szakmariadam/breathalyzer-project/pcb/breathalyzer/models/25SH-B-04-TS.stp

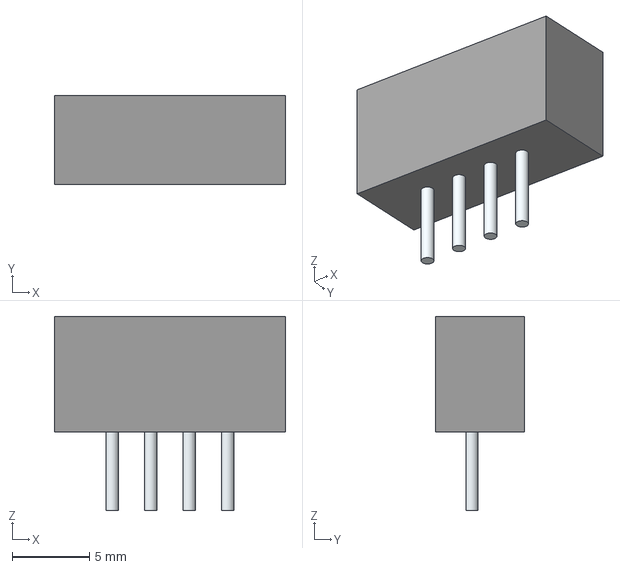
[picture p11: CAD file, 2025-05-30]
pcb/breathalyzer/models/25SH-B-04-TS.stp
15.0 x 5.75 x 12.6 mm
Leads
