szakmariadam/breathalyzer-project/pcb/breathalyzer/models/LCD-S301C31TR.stp

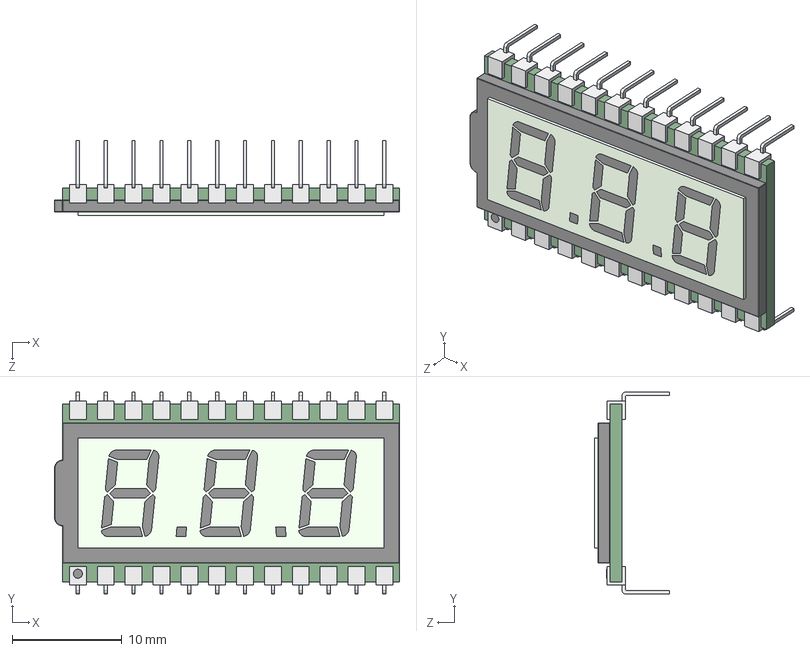
[picture p12: CAD file, 2025-05-30]
pcb/breathalyzer/models/LCD-S301C31TR.stp
31.5 x 18.4 x 6.80 mm
pcb
terminal_13
terminal_14
terminal_11
terminal_22
terminal_4
terminal_12
terminal_20
terminal_5
terminal_15
terminal_10
terminal_24
terminal_23
terminal_3
terminal_21
terminal_7
terminal_6
terminal
terminal_17
terminal_8
terminal_19
terminal_9
terminal_16
terminal_18
terminal_2
lcd base
glass
digits
digits_10
digits_16
digits_17
digits_2
digits_18
digits_9
digits_20
digits_5
digits_7
digits_21
digits_19
digits_15
digits_23
digits_12
digits_11
digits_4
digits_3
digits_22
digits_13
digits_6
digits_8
digits_14
logo_2
