szakmariadam/breathalyzer-project/pcb/breathalyzer/models/CPT-14146-80T.stp

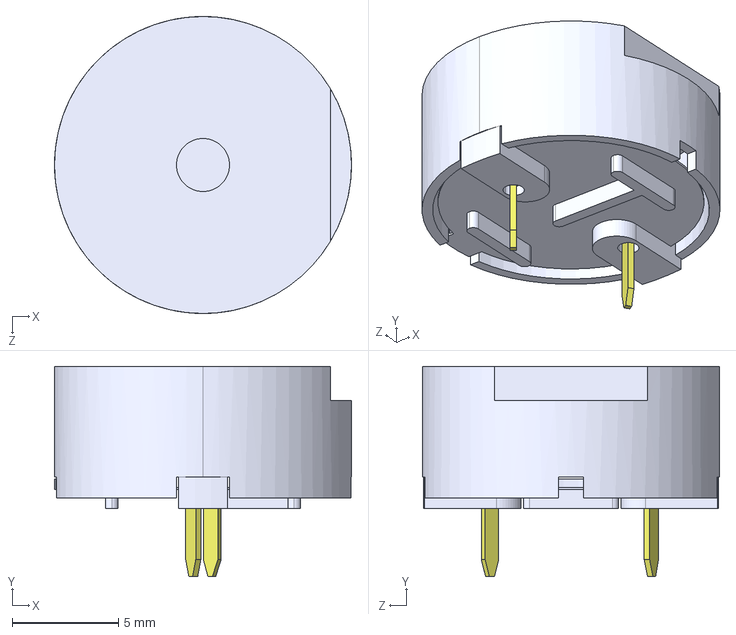
[picture p13: CAD file, 2025-05-30]
pcb/breathalyzer/models/CPT-14146-80T.stp
14.0 x 9.90 x 14.0 mm
