szakmariadam/breathalyzer-project/pcb/breathalyzer/models/22-28-8073.stp

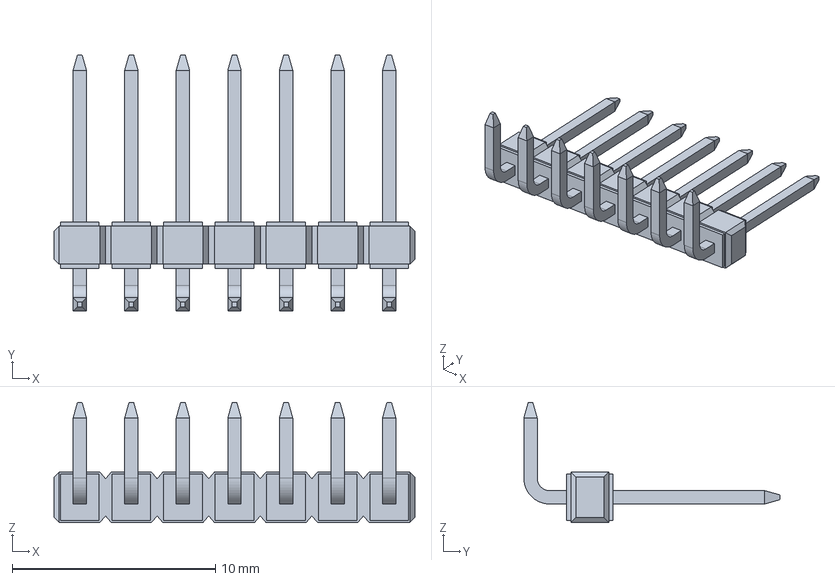
[picture p14: CAD file, 2025-05-30]
pcb/breathalyzer/models/22-28-8073.stp
17.8 x 12.6 x 5.92 mm
