szakmariadam/breathalyzer-project/pcb/breathalyzer/models/44J_ATM.step

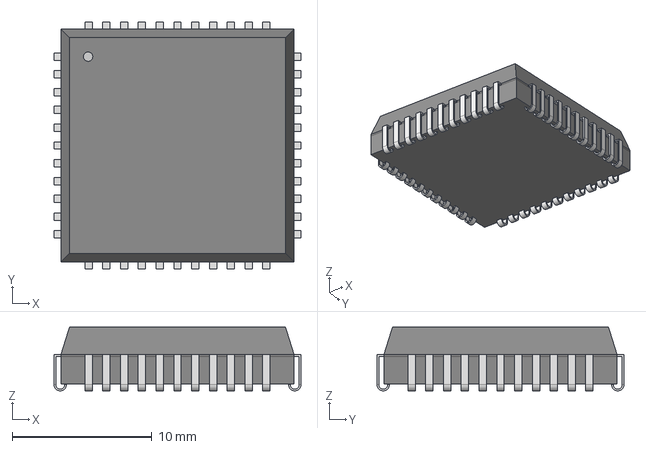
[picture p15: CAD file, 2025-05-30]
pcb/breathalyzer/models/44J_ATM.step
17.7 x 17.7 x 4.56 mm
