szakmariadam/breathalyzer-project/pcb/breathalyzer/models/Download_STP_430162085826_rev1.stp

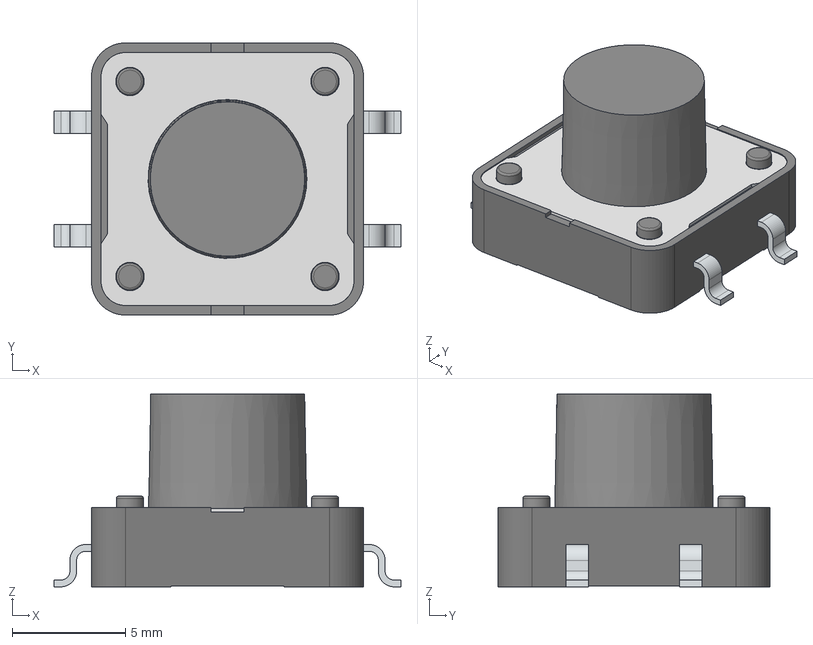
[picture p16: CAD file, 2025-05-30]
pcb/breathalyzer/models/Download_STP_430162085826_rev1.stp
15.3 x 12.0 x 8.50 mm
Contactplates x 5
Frame x 5
Contact Plate
Cover
Stem
Terminal x 4
