szakmariadam/breathalyzer-project/pcb/breathalyzer/models/PTS636SM43JSMTR_LFS.stp

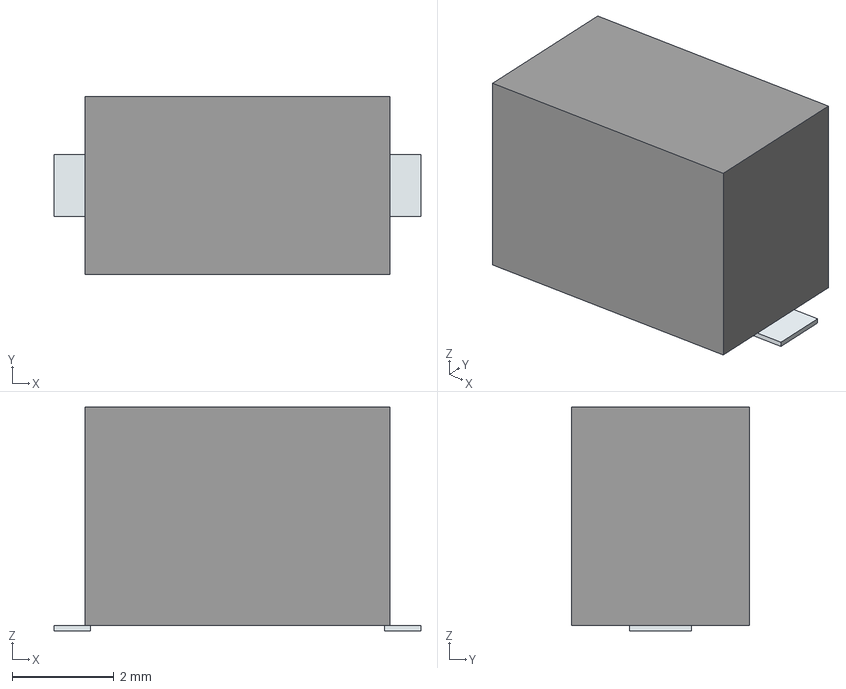
[picture p17: CAD file, 2025-05-30]
pcb/breathalyzer/models/PTS636SM43JSMTR_LFS.stp
7.22 x 3.50 x 4.40 mm
Pins
