szakmariadam/breathalyzer-project/pcb/breathalyzer/models/140-504-415-001.stp

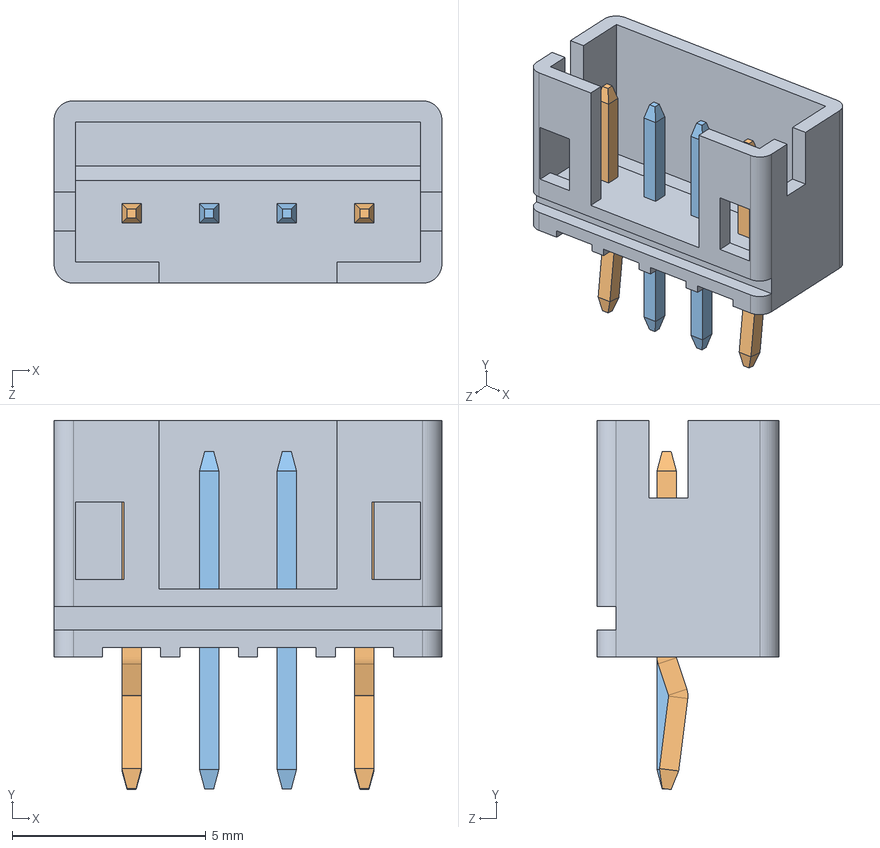
[picture p18: CAD file, 2025-05-30]
pcb/breathalyzer/models/140-504-415-001.stp
10.0 x 9.51 x 4.70 mm
V Housing_504
V Contact_Kink x 2
V Contact_Str x 2
