szakmariadam/breathalyzer-project/pcb/breathalyzer/models/PTS636_SK25F_SMTR_LFS.stp

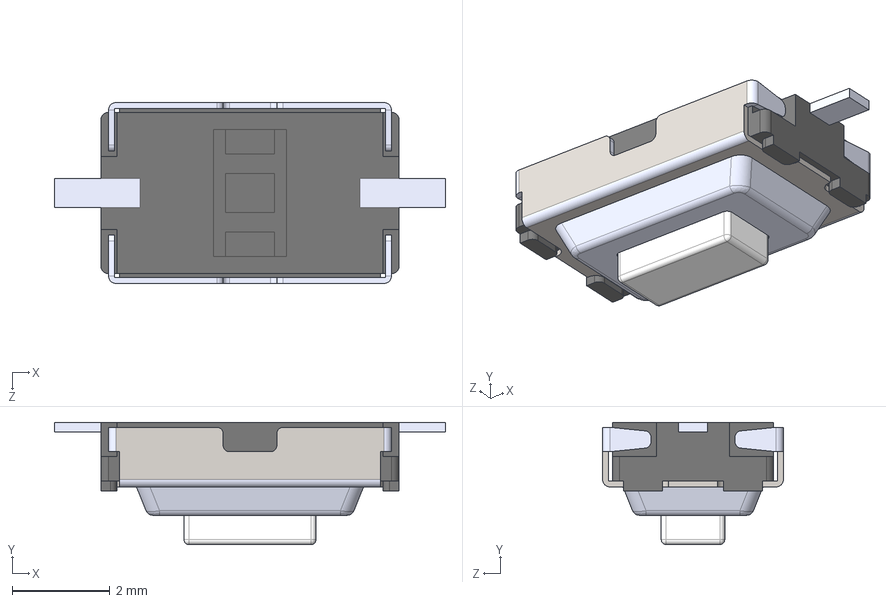
[picture p19: CAD file, 2025-05-30]
pcb/breathalyzer/models/PTS636_SK25F_SMTR_LFS.stp
8.00 x 2.50 x 3.70 mm
