szakmariadam/breathalyzer-project/pcb/breathalyzer/models/430162085826.stp

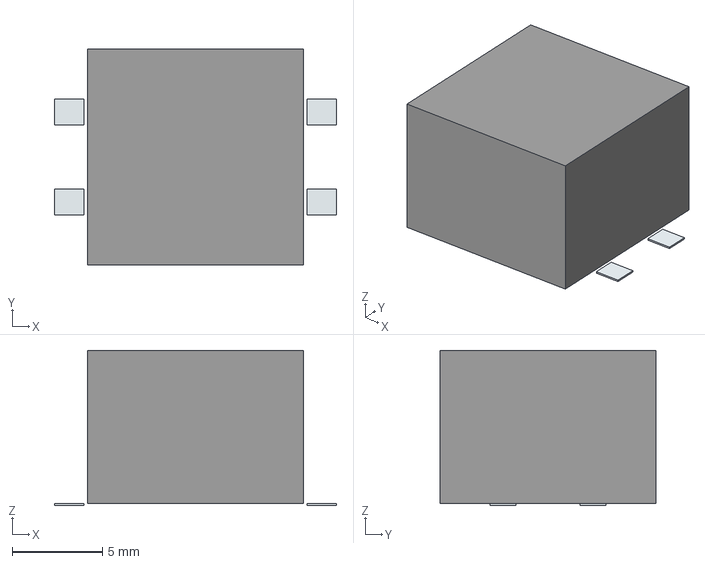
[picture p20: CAD file, 2025-05-30]
pcb/breathalyzer/models/430162085826.stp
15.6 x 12.0 x 8.60 mm
Pins
