szakmariadam/breathalyzer-project/pcb/breathalyzer/models/440055-2.stp

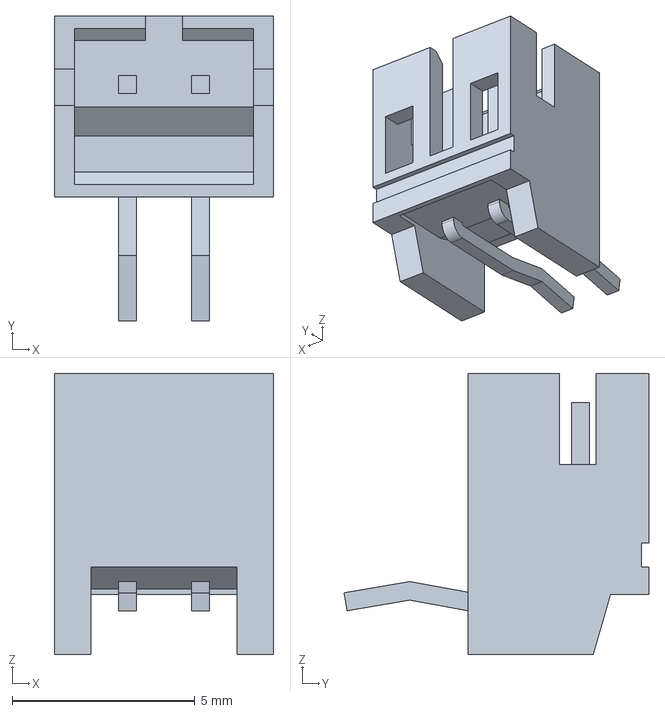
[picture p21: CAD file, 2025-05-30]
pcb/breathalyzer/models/440055-2.stp
6.00 x 8.35 x 7.70 mm
