szakmariadam/breathalyzer-project/pcb/breathalyzer/models/601030.stp

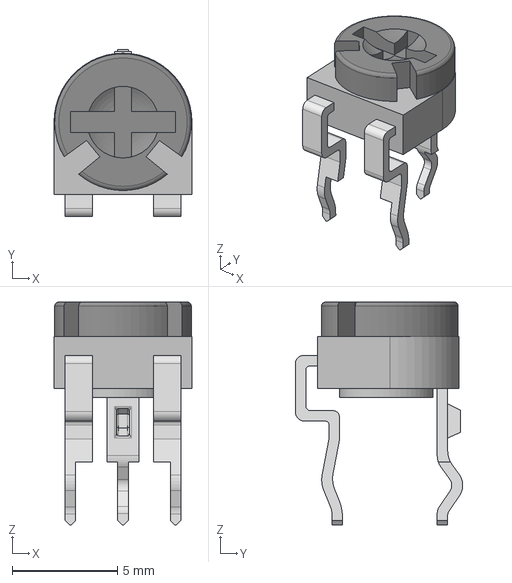
[picture p22: CAD file, 2025-05-30]
pcb/breathalyzer/models/601030.stp
6.56 x 7.96 x 10.6 mm
