szakmariadam/breathalyzer-project/pcb/breathalyzer/breathalyzer.kicad_pcb

## KiCad design pcb/breathalyzer/breathalyzer.kicad_pcb (2025-05-30)

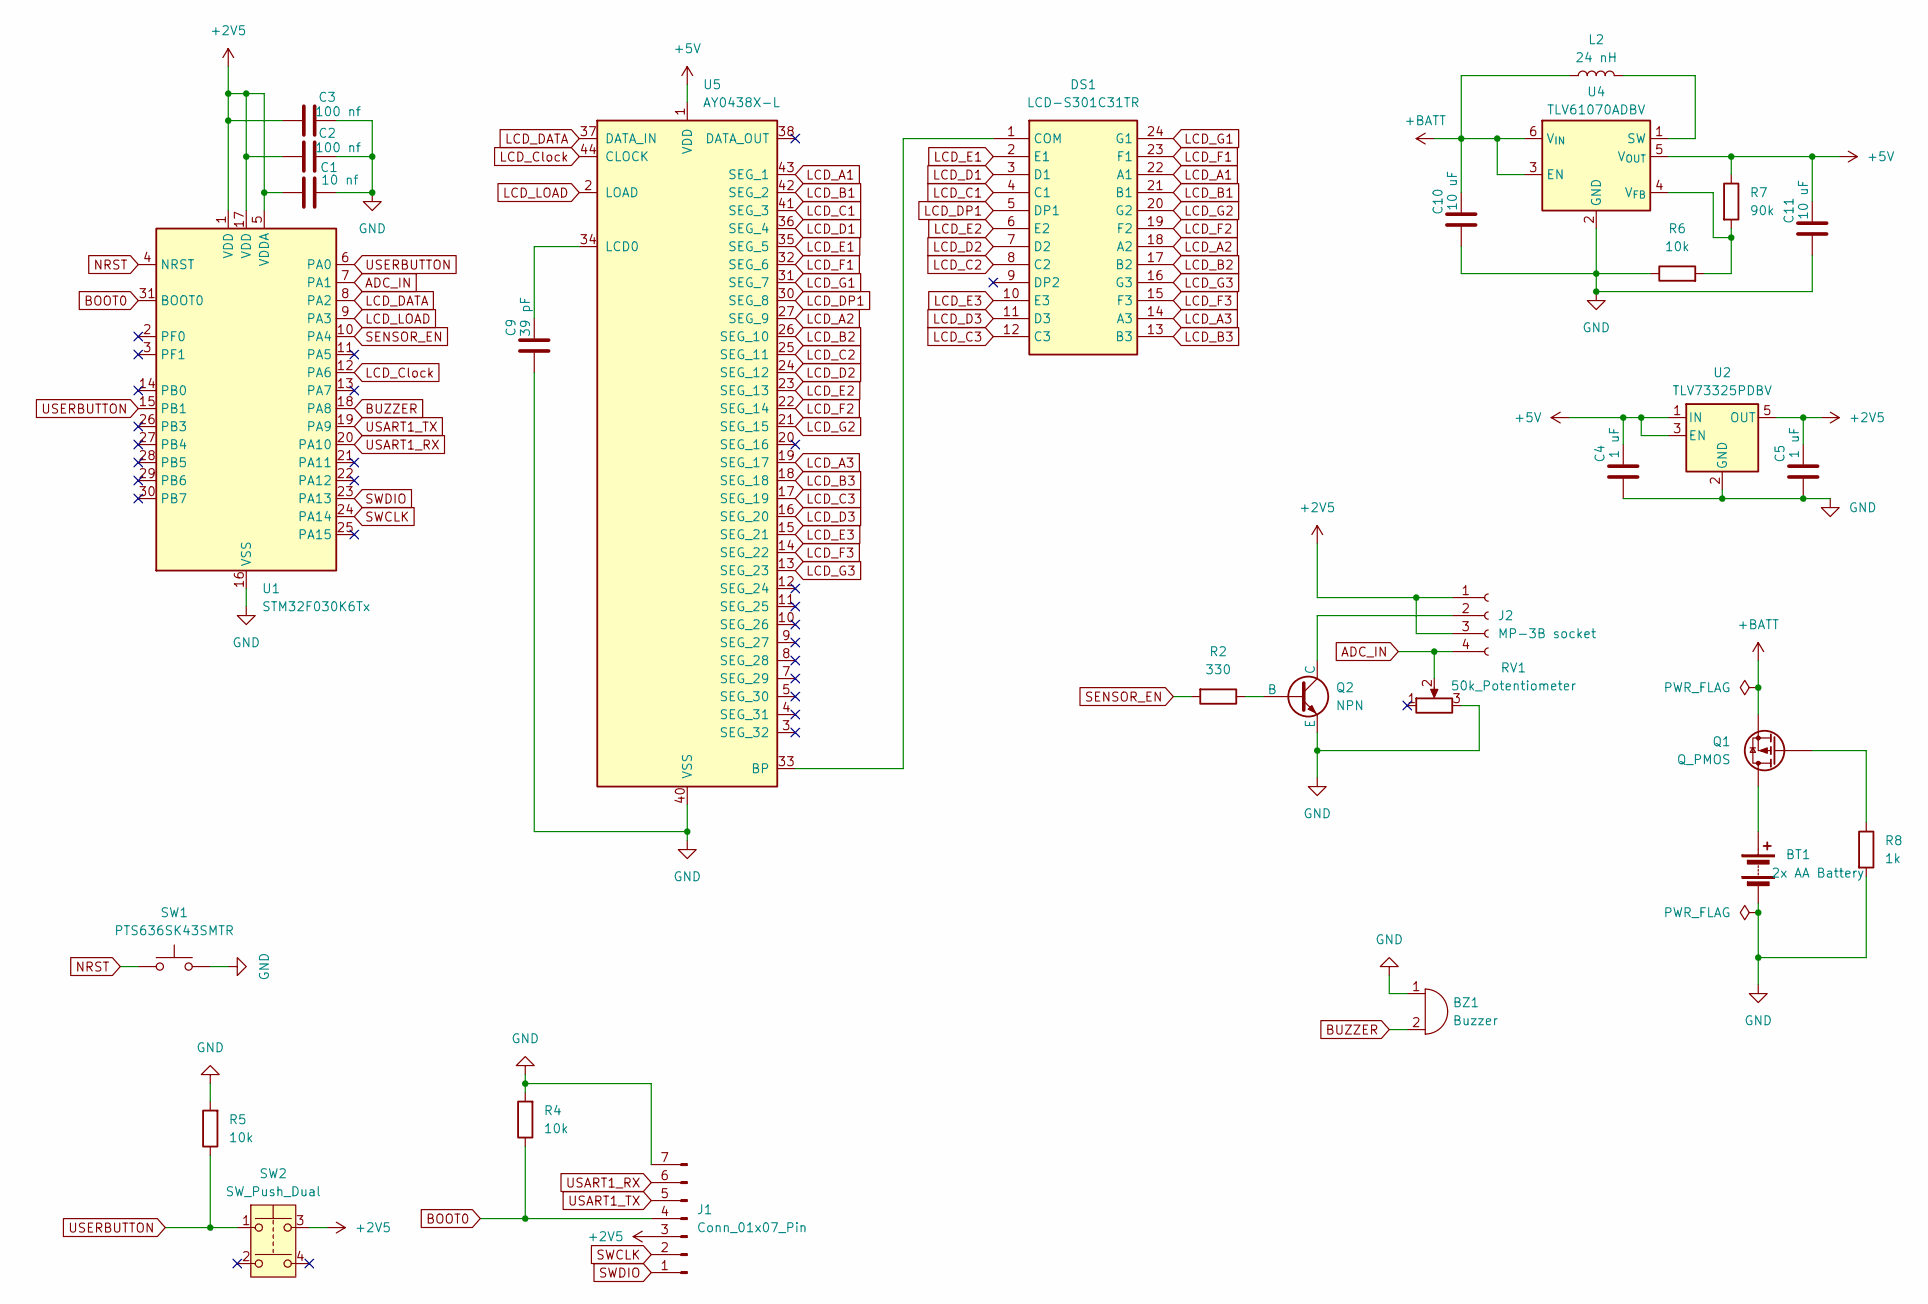
[picture p23: schematic breathalyzer.kicad_sch]

Parts:
BT1: 2x AA Battery; SHDRRA2W50P0X200_1X2_600X770X525P
BZ1: Buzzer; CPT1414680T
C1: 10 nf; C_01005_0402Metric
C2, C3: 100 nf; C_0402_1005Metric
C4, C5: 1 uF; C_0603_1608Metric
C9: 39 pF; C_0603_1608Metric
C10, C11: 10 uF; C_0805_2012Metric
DS1: LCD-S301C31TR; Mouser Part Number 696-LCD-S301C31TR
J1: Conn_01x07_Pin; HDRRA7W66P0X254_1X7_1778X229X274P
J2: MP-3B socket; 25SHB04TS
L2: 24 nH; L_1008_2520Metric
Q1: Q_PMOS; SOT-23-3
Q2: NPN; SOT-23-3
R2: 330; R_0805_2012Metric
R4, R5, R6: 10k; R_0603_1608Metric
R7: 90k; R_1206_3216Metric
R8: 1k; R_0603_1608Metric
RV1: 50k_Potentiometer; Potentiometer_ACP_CA9-H5_Horizontal
SW1: PTS636SK43SMTR; PTS636SM43JSMTRLFS
SW2: SW_Push_Dual; 430162085826
U1: STM32F030K6Tx; LQFP-32_7x7mm_P0.8mm
U2: TLV73325PDBV; SOT-23-5
U4: TLV61070ADBV; SOT-23-6
U5: AY0438X-L; PLCC-44

Connections:
+2V5: C1.1, C2.1, C3.1, C5.2, J1.3, J2.1, J2.3, SW2.3, U1.1 (VDD), U1.5 (VDDA), U1.17 (VDD), U2.5 (OUT)
+5V: C4.2, C11.2, R7.1, U2.1 (IN), U2.3 (EN), U4.5 (V_{OUT}), U5.1 (VDD)
+BATT: C10.2, L2.1, Q1.2 (S), U4.3 (EN), U4.6 (V_{IN})
ADC_IN: J2.4, RV1.2, U1.7 (PA1)
BOOT0: J1.4, R4.1, U1.31 (BOOT0)
BUZZER: BZ1.2 (-), U1.18 (PA8)
GND: BT1.2 (-), BZ1.1 (+), C1.2, C2.2, C3.2, C4.1, C5.1, C9.1, C10.1, C11.1, J1.7, Q2.3 (E), R4.2, R5.2, R6.1, R8.2, RV1.3, SW1.2, U1.16 (VSS), U1.32 (VSS), U2.2 (GND), U4.2 (GND), U5.40 (VSS)
LCD_A1: DS1.22 (A1), U5.43 (SEG_1)
LCD_A2: DS1.18 (A2), U5.27 (SEG_9)
LCD_A3: DS1.14 (A3), U5.19 (SEG_17)
LCD_B1: DS1.21 (B1), U5.42 (SEG_2)
LCD_B2: DS1.17 (B2), U5.26 (SEG_10)
LCD_B3: DS1.13 (B3), U5.18 (SEG_18)
LCD_C1: DS1.4 (C1), U5.41 (SEG_3)
LCD_C2: DS1.8 (C2), U5.25 (SEG_11)
LCD_C3: DS1.12 (C3), U5.17 (SEG_19)
LCD_Clock: U1.12 (PA6), U5.44 (CLOCK)
LCD_D1: DS1.3 (D1), U5.36 (SEG_4)
LCD_D2: DS1.7 (D2), U5.24 (SEG_12)
LCD_D3: DS1.11 (D3), U5.16 (SEG_20)
LCD_DATA: U1.8 (PA2), U5.37 (DATA_IN)
LCD_DP1: DS1.5 (DP1), U5.30 (SEG_8)
LCD_E1: DS1.2 (E1), U5.35 (SEG_5)
LCD_E2: DS1.6 (E2), U5.23 (SEG_13)
LCD_E3: DS1.10 (E3), U5.15 (SEG_21)
LCD_F1: DS1.23 (F1), U5.32 (SEG_6)
LCD_F2: DS1.19 (F2), U5.22 (SEG_14)
LCD_F3: DS1.15 (F3), U5.14 (SEG_22)
LCD_G1: DS1.24 (G1), U5.31 (SEG_7)
LCD_G2: DS1.20 (G2), U5.21 (SEG_15)
LCD_G3: DS1.16 (G3), U5.13 (SEG_23)
LCD_LOAD: U1.9 (PA3), U5.2 (LOAD)
NRST: SW1.1, U1.4 (NRST)
unnamed: BT1.1 (+), Q1.3 (D)
unnamed: DS1.1 (COM), U5.33 (BP)
unnamed: J2.2, Q2.1 (C)
unnamed: Q1.1 (G), R8.1
unnamed: Q2.2 (B), R2.1
unnamed: L2.2, U4.1 (SW)
unnamed: R6.2, R7.2, U4.4 (V_{FB})
unnamed: C9.2, U5.34 (LCD0)
SENSOR_EN: R2.2, U1.10 (PA4)
SWCLK: J1.2, U1.24 (PA14)
SWDIO: J1.1, U1.23 (PA13)
USART1_RX: J1.6, U1.20 (PA10)
USART1_TX: J1.5, U1.19 (PA9)
USERBUTTON: R5.1, SW2.1, U1.6 (PA0), U1.15 (PB1)

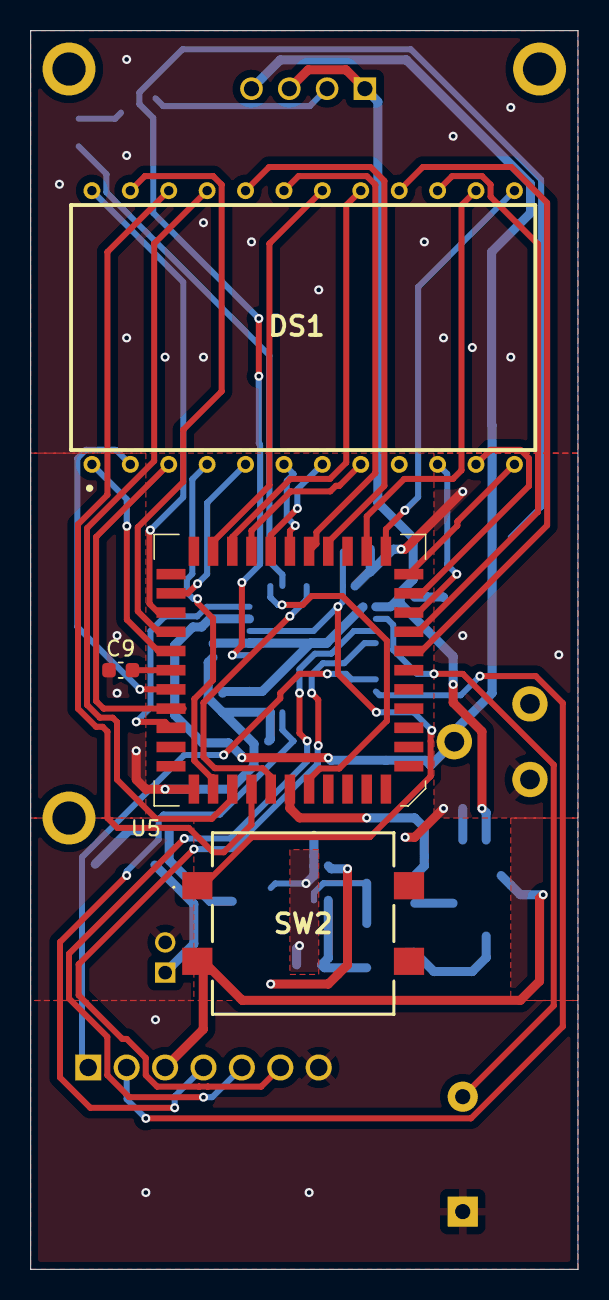
[picture p24: board breathalyzer.kicad_pcb from above]

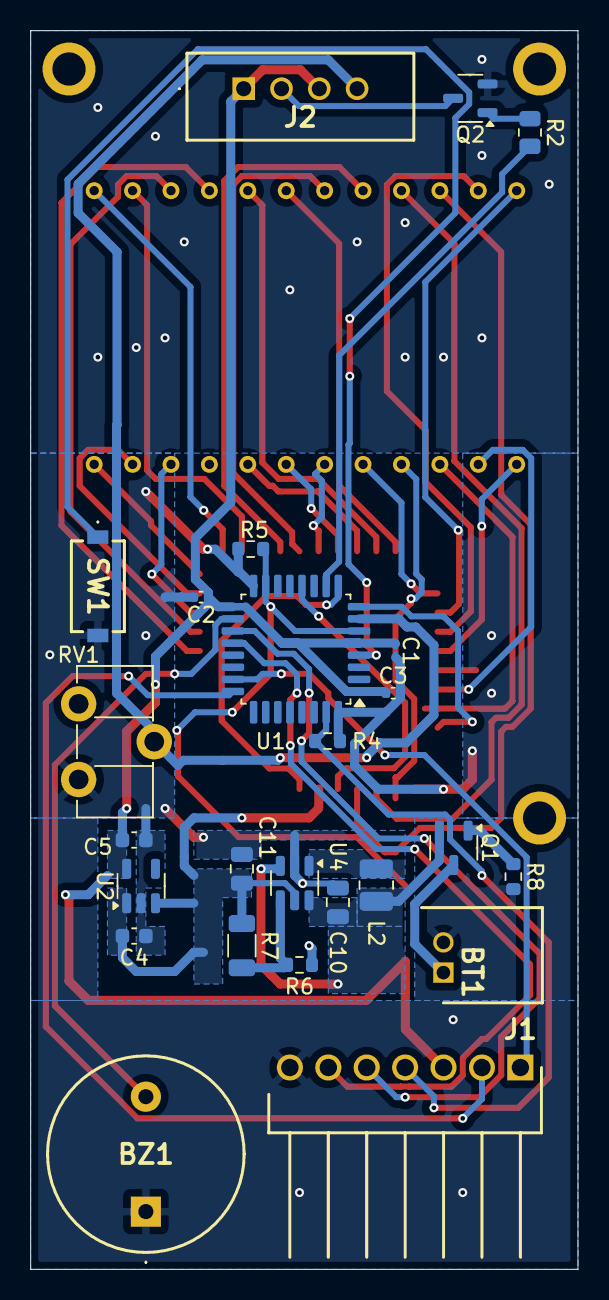
[picture p25: board breathalyzer.kicad_pcb from below]

Board: 2 copper layers, 36.2 x 81.9 mm, 32 parts (25 on the bottom side), 47 nets.

Other parts of the board:
H1, H1#2, H1#3: MountingHole; MountingHole_2.2mm_M2_ISO7380_Pad
