szakmariadam/breathalyzer-project/STM32CubeIDE_workspace/breathalyzer_nucleo/Core/Src/main.c

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
/* Includes ------------------------------------------------------------------*/
#include "main.h"

/* USER CODE BEGIN Includes */

#include <math.h>
#include <stdlib.h>

/* USER CODE END Includes */

/* USER CODE BEGIN PTD */

typedef struct{
  GPIO_PinState D;
  GPIO_PinState C;
  GPIO_PinState B;
  GPIO_PinState A;
} sevenSegmentDriver;

/* USER CODE END PTD */

/* USER CODE BEGIN PD */

#define VC 2.27f //manually calibrated
#define VCC 3.06f //manually calibrated
#define RL 33333.3f //not calibrated
#define R0 23000 //calibrated

/* USER CODE END PD */

ADC_HandleTypeDef hadc1;

TIM_HandleTypeDef htim1;
TIM_HandleTypeDef htim2;
TIM_HandleTypeDef htim3;
TIM_HandleTypeDef htim4;

/* USER CODE BEGIN PV */

uint16_t ADC_result_temp;
uint16_t ADC_result;
uint16_t display_value = 0;
uint16_t display_temp = 0;
uint8_t digit = 5; //iterator for 7-segment display, starts from 5
uint8_t maxDigits = 0;
GPIO_PinState buttonState = GPIO_PIN_RESET;
float BrAC = 0.0f;  //mg/L
float BAC = 0.0f; //%
uint8_t warmedUp = 0;
uint16_t ADC_measure_max = 0;
uint8_t measuring = 0; // Flag for measuring state
uint32_t measureCounter = 0; // Counter for measuring time
float sensorVoltage = 0.0f;
float RLVoltage = 0.0f;
uint32_t sensorResistance = 0;
uint32_t buzzerCounter = 0; // Counter for buzzer time

sevenSegmentDriver driverCode[11] = {
  {GPIO_PIN_RESET, GPIO_PIN_RESET, GPIO_PIN_RESET, GPIO_PIN_RESET}, //0
  {GPIO_PIN_RESET, GPIO_PIN_RESET, GPIO_PIN_RESET, GPIO_PIN_SET},   //1
  {GPIO_PIN_RESET, GPIO_PIN_RESET, GPIO_PIN_SET, GPIO_PIN_RESET},   //2
  {GPIO_PIN_RESET, GPIO_PIN_RESET, GPIO_PIN_SET, GPIO_PIN_SET},     //3
  {GPIO_PIN_RESET, GPIO_PIN_SET, GPIO_PIN_RESET, GPIO_PIN_RESET},   //4
  {GPIO_PIN_RESET, GPIO_PIN_SET, GPIO_PIN_RESET, GPIO_PIN_SET},     //5
  {GPIO_PIN_RESET, GPIO_PIN_SET, GPIO_PIN_SET, GPIO_PIN_RESET},     //6
  {GPIO_PIN_RESET, GPIO_PIN_SET, GPIO_PIN_SET, GPIO_PIN_SET},       //7
  {GPIO_PIN_SET, GPIO_PIN_RESET, GPIO_PIN_RESET, GPIO_PIN_RESET},   //8
  {GPIO_PIN_SET, GPIO_PIN_RESET, GPIO_PIN_RESET, GPIO_PIN_SET},     //9
  {GPIO_PIN_SET, GPIO_PIN_SET, GPIO_PIN_SET, GPIO_PIN_SET}          //off
};

/* USER CODE END PV */

void SystemClock_Config(void);
static void MX_GPIO_Init(void);
static void MX_TIM2_Init(void);
static void MX_ADC1_Init(void);
static void MX_TIM1_Init(void);
static void MX_TIM3_Init(void);
static void MX_TIM4_Init(void);
/* USER CODE BEGIN PFP */

void setDigit(uint8_t value, uint8_t digit);
uint8_t countDigits(uint8_t num);
void TIM2_callback(void);
void TIM3_callback(void);
void TIM4_callback(void);
void UserButton_callback(void);
void getADCvalue(void);
void warmup(void);
void stopBuzzer(void);

/* USER CODE END PFP */

/**
  * @brief  The application entry point.
  * @retval int
  */
int main(void)
{

  /* MCU Configuration--------------------------------------------------------*/

  /* Reset of all peripherals, Initializes the Flash interface and the Systick. */
  HAL_Init();

  /* Configure the system clock */
  SystemClock_Config();

  /* Initialize all configured peripherals */
  MX_GPIO_Init();
  MX_TIM2_Init();
  MX_ADC1_Init();
  MX_TIM1_Init();
  MX_TIM3_Init();
  MX_TIM4_Init();
  /* USER CODE BEGIN 2 */

  /* Run the ADC calibration */
  if (HAL_ADCEx_Calibration_Start(&hadc1) != HAL_OK)
  {
    /* Calibration Error */
    Error_Handler();
  }

  HAL_TIM_Base_Start_IT(&htim2);
  HAL_TIM_Base_Start_IT(&htim3);

  if(HAL_TIM_PWM_Start(&htim1,TIM_CHANNEL_1) != HAL_OK)
  	{
  		  /* Start Error */
  		  Error_Handler();
  	}

  HAL_GPIO_WritePin(LD2_GPIO_Port, LD2_Pin, GPIO_PIN_SET); // Power LED ON
  
  warmup(); // Wait for the sensor to warm up

  /* USER CODE END 2 */

  /* Infinite loop */
  /* USER CODE BEGIN WHILE */
  while (1)
  {

    /* USER CODE END WHILE */

    /* USER CODE BEGIN 3 */
  }
  /* USER CODE END 3 */
}

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
/* USER CODE BEGIN 4 */

void setDigit(uint8_t value, uint8_t digit)
{
  switch (digit){
    case 1:
      HAL_GPIO_WritePin(GPIOB, GPIO_PIN_5, GPIO_PIN_RESET);   //100
      HAL_GPIO_WritePin(GPIOB, GPIO_PIN_4, GPIO_PIN_RESET);   //10
      HAL_GPIO_WritePin(GPIOB, GPIO_PIN_10, GPIO_PIN_SET);  //1
      HAL_GPIO_WritePin(dp_GPIO_Port, dp_Pin, GPIO_PIN_SET); //DP
      break;
    case 2:
      HAL_GPIO_WritePin(GPIOB, GPIO_PIN_5, GPIO_PIN_RESET);   //100
      HAL_GPIO_WritePin(GPIOB, GPIO_PIN_4, GPIO_PIN_SET);   //10
      HAL_GPIO_WritePin(GPIOB, GPIO_PIN_10, GPIO_PIN_RESET);  //1
      HAL_GPIO_WritePin(dp_GPIO_Port, dp_Pin, GPIO_PIN_SET); //DP
      break;
    case 3:
      HAL_GPIO_WritePin(GPIOB, GPIO_PIN_5, GPIO_PIN_SET);   //100
      HAL_GPIO_WritePin(GPIOB, GPIO_PIN_4, GPIO_PIN_RESET);   //10
      HAL_GPIO_WritePin(GPIOB, GPIO_PIN_10, GPIO_PIN_RESET);  //1
      HAL_GPIO_WritePin(dp_GPIO_Port, dp_Pin, GPIO_PIN_RESET); //DP
      break;
    default:
      HAL_GPIO_WritePin(GPIOB, GPIO_PIN_5, GPIO_PIN_RESET);   //100
      HAL_GPIO_WritePin(GPIOB, GPIO_PIN_4, GPIO_PIN_RESET);   //10
      HAL_GPIO_WritePin(GPIOB, GPIO_PIN_10, GPIO_PIN_RESET);  //1
      HAL_GPIO_WritePin(dp_GPIO_Port, dp_Pin, GPIO_PIN_SET); //DP
      break;
  }
  if(value < 11)
  {
    HAL_GPIO_WritePin(GPIOB, GPIO_PIN_8, driverCode[value].A); //A
    HAL_GPIO_WritePin(GPIOB, GPIO_PIN_9, driverCode[value].B); //B
    HAL_GPIO_WritePin(GPIOA, GPIO_PIN_6, driverCode[value].C); //C
    HAL_GPIO_WritePin(GPIOA, GPIO_PIN_7, driverCode[value].D); //D
  }
}

void TIM3_callback(void)
{
  //measure
  if(measuring)
  {
    //measure start
    getADCvalue(); // Get ADC value
    if(ADC_result > ADC_measure_max)
    {
      ADC_measure_max = ADC_result; // Get max ADC value
    }
    
    measureCounter++;
    
    switch (measureCounter)
    {
    case 1:
      ADC_measure_max = 0; // Reset max ADC value
      sensorVoltage = 0.0f; // Reset sensor voltage
      sensorResistance = 0; // Reset sensor resistance
      RLVoltage = 0.0f;

      HAL_TIM_PWM_Start(&htim2, TIM_CHANNEL_1); // Start buzzer

      break;
    case 7000:
      measuring = 0; // Stop measuring
      measureCounter = 0; // Reset counter


      //TODO: Calculate BAC value
      RLVoltage = (ADC_measure_max * VCC) / 4096.0f; // Convert ADC value to RL voltage
      sensorVoltage = VC - RLVoltage; // Convert RL voltage to sensor voltage
      sensorResistance = sensorVoltage * RL / (VC - sensorVoltage); // Calculate sensor resistance
      BrAC = 0.366 * pow((10*sensorResistance)/R0, -1.509); //sensor characteristics from datasheet
      BAC = ((BrAC*2100)/1000)/10;  //2100 BrAC to BAC conversion factor

      display_value = round(BAC * 100); // Convert voltage to display value

      HAL_TIM_PWM_Start(&htim2, TIM_CHANNEL_1); // Start buzzer
      HAL_TIM_Base_Start_IT(&htim4);  // standby timeout
    default:
      break;
    }
  }

  //set display
  if (digit<=3)
  {

    setDigit(display_temp%10, digit); // Set the digit to display
    display_temp = display_temp/10;

    digit++;
  }
  else
  {
    display_temp = display_value;

    digit = 1;
  }
}

uint8_t countDigits(uint8_t num) { //for 7 segment display
  if (num == 0) return 1; // Special case for 0
  return (uint8_t)log10(abs(num)) + 1;
}

void stopBuzzer(void)
{
  HAL_TIM_PWM_Stop(&htim2, TIM_CHANNEL_1); // Stop buzzer
}

void TIM2_callback(void)
{
  buzzerCounter++;
  if(buzzerCounter >= 500) // 0.5 second
  {
    buzzerCounter = 0; // Reset counter
    stopBuzzer(); // Stop buzzer
  }
}

void TIM4_callback(void)
{
  if (__HAL_PWR_GET_FLAG(PWR_FLAG_SB) != RESET)
  {
    __HAL_PWR_CLEAR_FLAG(PWR_FLAG_SB); // Clear Standby flag
    // Proceed to main application
  }
  else
  {
    HAL_GPIO_WritePin(LD2_GPIO_Port, LD2_Pin, GPIO_PIN_SET); // Power LED OFF

    HAL_PWR_DisableWakeUpPin(PWR_WAKEUP_PIN1); // Disable before configuring

    __HAL_PWR_CLEAR_FLAG(PWR_FLAG_WU | PWR_FLAG_SB); // Clear wakeup & standby flags

    HAL_PWR_EnableWakeUpPin(PWR_WAKEUP_PIN1); // Enable wakeup pin

    HAL_PWR_EnterSTANDBYMode(); // Enter standby mode
  }
}

void userButton_callback(void)
{
  if(warmedUp){
    HAL_TIM_Base_Stop_IT(&htim4); // stop and reset standby timeout
    __HAL_TIM_SET_COUNTER(&htim4, 0);

    measuring = 1; // Start measuring
  }
}

void getADCvalue(void)
{
  //ADC polling
  if (HAL_ADC_Start(&hadc1) != HAL_OK)
	{
	  /* Start Error */
	  Error_Handler();
	}

  ADC_result_temp = 0;

	for(uint16_t i = 0; i<255; i++)
	{
	  HAL_ADC_PollForConversion(&hadc1, 1000);
	  ADC_result_temp += HAL_ADC_GetValue(&hadc1);
    ADC_result_temp = ADC_result_temp/2;
	}

	ADC_result = ADC_result_temp;

	HAL_ADC_Stop(&hadc1);
}

void warmup(void)
{

  display_value = 0.0f * 100;
  //getADCvalue(); // Get ADC value

  HAL_Delay(10000);

  warmedUp = 1;
  HAL_TIM_PWM_Start(&htim2, TIM_CHANNEL_1); // Start buzzer

  HAL_TIM_Base_Start_IT(&htim4); // standby timeout

  /* EXTI interrupt init*/
  HAL_NVIC_SetPriority(EXTI9_5_IRQn, 0, 0);
  HAL_NVIC_EnableIRQ(EXTI9_5_IRQn);
}

/* USER CODE END 4 */
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
