szakmariadam/breathalyzer-project/STM32CubeIDE_workspace/breathalyzer_nucleo/breathalyzer_nucleo.ioc

Mcu.UserName=STM32F103RBTx
PA0-WKUP.Signal=SYS_WKUP
PA1.Signal=ADCx_IN1
PA10.GPIO_Label=dp
PA10.Signal=GPIO_Output
PA13.GPIO_Label=TMS
PA13.Signal=SYS_JTMS-SWDIO
PA14.GPIO_Label=TCK
PA14.Signal=SYS_JTCK-SWCLK
PA15.Signal=S_TIM2_CH1_ETR
PA5.GPIO_Label=LD2 [Green Led]
PA5.Signal=GPIO_Output
PA6.Signal=GPIO_Output
PA7.Signal=GPIO_Output
PA8.Signal=S_TIM1_CH1
PB10.Signal=GPIO_Output
PB3.GPIO_Label=SWO
PB3.Signal=SYS_JTDO-TRACESWO
PB4.Signal=GPIO_Output
PB5.Signal=GPIO_Output
PB6.GPIO_Label=UserButton
PB6.Signal=GPXTI6
PB8.Signal=GPIO_Output
PB9.Signal=GPIO_Output
PC14-OSC32_IN.Signal=RCC_OSC32_IN
PC15-OSC32_OUT.Signal=RCC_OSC32_OUT
PD0-OSC_IN.Signal=RCC_OSC_IN
PD1-OSC_OUT.Signal=RCC_OSC_OUT
