szakmariadam/breathalyzer-project/STM32CubeIDE_workspace/breathalyzer_nucleo/Core/Inc/main.h

#define LD2_Pin GPIO_PIN_5
#define LD2_GPIO_Port GPIOA
#define dp_Pin GPIO_PIN_10
#define dp_GPIO_Port GPIOA
#define TMS_Pin GPIO_PIN_13
#define TMS_GPIO_Port GPIOA
#define TCK_Pin GPIO_PIN_14
#define TCK_GPIO_Port GPIOA
#define SWO_Pin GPIO_PIN_3
#define SWO_GPIO_Port GPIOB
#define UserButton_Pin GPIO_PIN_6
#define UserButton_GPIO_Port GPIOB
#define UserButton_EXTI_IRQn EXTI9_5_IRQn
