szakmariadam/breathalyzer-project/(commit log)

2025-02-23 Empty project with LED blink
2025-03-15 init GPIOs for 7 segment driver
2025-03-15 7 segment driver GPIOs testing
2025-03-19 polling ADC
2025-03-20 ADC calib
2025-03-20 PWM init
    Added HAL_ADC_Stop()
2025-03-26 ADC result averages
2025-03-27 PWM set to 2V31
2025-03-29 PWM set to 2V475
2025-03-30 tim3 interrupt setup
    setSegment error handling
    [breathalyzer_nucleo.ioc, main.c, main.h]
2025-04-02 7 segment driver
2025-04-02 7 segment driver fix
    display driver doesn't display empty digits
    [main.c]
2025-04-02 set up user button
2025-04-02 ADC moved to PA1
    and sysWakeup was initialized on pa0
2025-04-03 10 sec timeout to standby
    init TIM4
    standby in interrupt
    wake up signal
2025-04-09 replaced blink with static power LED
    tim2 unused
    [main.c]
2025-04-10 setup TIM2 as 1kHz 50D PWM for buzzer
    half sec beep on start
    commented standby timeout for dev
    [breathalyzer_nucleo.ioc, main.c]
2025-04-14 added interrupt for UserButton
2025-04-15 removed the 1000 digit
    added fix decimal point
    [breathalyzer_nucleo.ioc, main.c, main.h]
2025-04-22 sensor warmup function
2025-04-22 empty measure function on button press
2025-04-23 moved measure function to TIM3 interrupt
    basic ADC measuring for 10 sec
    commented out timeout for dev
2025-04-23 calculated sensor resistance
2025-04-24 ADC ref voltage calibration
    RLVoltage for debug
2025-04-26 Calculate BAC% from sensor resistance
2025-05-04 empty kicad project
    [breathalyzer.kicad_pcb, breathalyzer.kicad_sch]
2025-05-06 LDO 2V5
    [breathalyzer.kicad_sch]
2025-05-07 voltage reference
    [breathalyzer.kicad_sch]
2025-05-08 boost 3v3
    [breathalyzer.kicad_sch]
2025-05-08 program MCU
    [breathalyzer.kicad_pcb, breathalyzer.kicad_sch]
2025-05-08 Serial debug
    [breathalyzer.kicad_sch]
2025-05-08 reset button
    [breathalyzer.kicad_pcb, breathalyzer.kicad_sch]
2025-05-09 change pull-down resistor for BOOT0 and bootloader mode
    [breathalyzer.kicad_sch]
2025-05-09 wakeup button
    [breathalyzer.kicad_sch]
2025-05-09 display parts chosen
    [breathalyzer.kicad_pcb, breathalyzer.kicad_sch]
2025-05-10 numeric LCD display and driver
    +5V boost
    previous parts scrapped
    [breathalyzer.kicad_pcb, breathalyzer.kicad_sch]
2025-05-10 removed 3V3 boost
    [breathalyzer.kicad_pcb, breathalyzer.kicad_sch]
2025-05-11 reverse polarity protection
    [breathalyzer.kicad_pcb, breathalyzer.kicad_sch]
2025-05-11 changed power supply
    5V boost from BATT
    2V5 LDO from 5V
    [breathalyzer.kicad_pcb, breathalyzer.kicad_sch]
2025-05-19 sensor connector
    [breathalyzer.kicad_pcb, breathalyzer.kicad_sch]
2025-05-20 finalized schematic
    [breathalyzer.kicad_sch]
2025-05-20 update from schematic
    [breathalyzer.kicad_pcb, breathalyzer.kicad_sch]
2025-05-20 test
    modified RL
    added round() to BAC
    fixed 10s heatup
    [main.c]
2025-05-20 net classes
    [breathalyzer.kicad_pcb]
2025-05-20 5V fix
    [breathalyzer.kicad_pcb, breathalyzer.kicad_sch]
2025-05-22 pcb layout
    [breathalyzer.kicad_pcb]
2025-05-22 layout update
    [breathalyzer.kicad_pcb]
2025-05-22 layout update
    shorter board
    [breathalyzer.kicad_pcb]
2025-05-22 added 3d models
    [25SH-B-04-TS.stp, 44J_ATM.step, LCD-S301C31TR.stp, breathalyzer.kicad_pcb]
2025-05-23 all models
    [140-504-415-001.stp, 22-28-8073.stp, 430162085826.stp, 440055-2.stp, 601030.stp, CPT-14146-80T.stp, Download_STP_430162085826_rev1.stp, PTS636SM43JSMTR_LFS.stp]
2025-05-23 trace correction
    [breathalyzer.kicad_pcb]
2025-05-23 layout correction
    [breathalyzer.kicad_pcb, breathalyzer.kicad_sch]
2025-05-23 unfilled GND zones
    [breathalyzer.kicad_pcb]
2025-05-23 GND zones with cutout power area
    [breathalyzer.kicad_pcb]
2025-05-23 pcb complete no errors
    [breathalyzer.kicad_pcb]
2025-05-23 extra vias
    [breathalyzer.kicad_pcb]
2025-05-23 mounting holes
    [breathalyzer.kicad_pcb]
2025-05-23 no warnings
    [breathalyzer.kicad_pcb]
2025-05-25 layout update
    C closer to MCU
    [breathalyzer.kicad_pcb]
