szakmariadam/breathalyzer-project/(notices)

Notices in the files:
STM32CubeIDE_workspace/breathalyzer_nucleo/Core/Src/main.c:
Copyright (c) 2025 STMicroelectronics.
All rights reserved.
This software is licensed under terms that can be found in the LICENSE file
